ondras12345/AlarmClock-doc/sim/README.md

# Simulace
Simulace elektronických obvodů.

## LTspice
[LTspice XVII(x64) (17.0.32.0)][LTspice]

[LTspice]: https://www.analog.com/en/design-center/design-tools-and-calculators/ltspice-simulator.html

### Export do PDF
Normálně tiskne na spodním okraji cestu k souboru, ale lze to potlačit:

https://electronics.stackexchange.com/questions/365748/can-the-directory-path-on-the-schematics-be-disabled-for-the-print-in-ltspice
> If you click "Zoom to full extends" and then proceed it appears. But if you
> right after "Zoom to full extends" left click the mouse on the schematics
> anywhere and move the schematics even the smallest distance it doesn't
> appear.
