ondras12345/AlarmClock-doc/sim/models/README.md

# Third-party SPICE models
- https://www.diodes.com/part/view/BCP56/
