ondras12345/AlarmClock-doc/zkratky.tex

\nonuchapter{Seznam zkratek}
% POZOR podle abecedy to musim radit rucne...
% vim select in visual mode & :sort
\begin{acronym}[EEPROM] % nejdelsi zkratka kvuli zarovnani
    %\acro{ESD}{elektrostatický výboj}
    \acro{BLU}{podsvitová jednotka LCD\acroextra{ (\foreignlanguage{english}{backlight unit})}}
    \acro{CI}{průběžná integrace\acroextra{ (\foreignlanguage{english}{continuous integration})}}
    \acro{CLI}{příkazový řádek\acroextra{ (\foreignlanguage{english}{command line interface})}}
    \acro{CNC}{počítačové číslicové řízení\acroextra{ (\foreignlanguage{english}{computer numeric control})}}
    \acro{DPS}{deska plošných spojů}
    \acro{DRC}{\foreignlanguage{english}{Design Rules Checker}\acroextra{ (nástroj pro kontrolu návrhu DPS)}}
    \acro{EEPROM}{elektricky vymazatelná paměť pouze pro čtení\acroextra{ (\foreignlanguage{english}{electrically erasable programmable read-only memory})}}
    \acro{ERC}{\foreignlanguage{english}{Electrical Rules Checker}\acroextra{ (nástroj pro kontrolu elektrických pravidel)}}
    \acro{IDE}{vývojové prostředí\acroextra{ (\foreignlanguage{english}{integrated development environment})}}
    \acro{ISP}{\foreignlanguage{english}{in-system programming}}
    \acro{ISR}{obsluha přerušení\acroextra{ (\foreignlanguage{english}{interrupt service routine})}}
    \acro{LED}{elektroluminiscenční dioda\acroextra{ (\foreignlanguage{english}{light-emitting diode})}}
    \acro{LSB}{nejméně významný bit\acroextra{ (\foreignlanguage{english}{least significant bit})}}
    \acro{LUT}{vyhledávací tabulka\acroextra{ (\foreignlanguage{english}{lookup table})}}
    \acro{LWT}{\foreignlanguage{english}{Last Will and Testament}\acroextra{ (funkce protokolu MQTT)}}
    \acro{MCU}{mikrokontrolér\acroextra{ (jednočipový počítač; \foreignlanguage{english}{microcontroller unit})}}
    \acro{MSB}{nejvýznamnější bit\acroextra{ (\foreignlanguage{english}{most significant bit})}}
    \acro{PWM}{pulzně šířková modulace\acroextra{ (\foreignlanguage{english}{pulse-width modulation})}}
    \acro{RTC}{hodiny reálného času\acroextra{ (\foreignlanguage{english}{real-time clock})}}
    \acro{SDK}{software development kit}
    \acro{SMD}{součástka pro povrchovou montáž\acroextra{ (\foreignlanguage{english}{surface mount device})}}
    \acro{SRAM}{statická polovodičová pamět s~přímým přístupem\acroextra{ (\foreignlanguage{english}{static random-access memory})}}
    \acro{TTL}{\foreignlanguage{english}{transistor-transistor logic}}
    \acro{UART}{\foreignlanguage{english}{universal asynchronous receiver-transmitter}\acroextra{ (univerzální asynchronní přijímač-vysílač)}}
    \acro{WDT}{\foreignlanguage{english}{watchdog timer}}
    % TODO \acro{MQTT}{} ??
\end{acronym}
