ondras12345/AlarmClock-doc/dmp.tex

\documentclass[12pt,a4paper]{report}
\usepackage[utf8]{inputenc}
\usepackage[czech]{babel}
\usepackage[T1]{fontenc}

% radkovani 1,5, ale ne u footnotes, literatury, ...
% baselinestretch 1.3 je radkovani 1,5
% https://theses.cz/id/say3ul/BP.pdf
% http://mirrors.nic.cz/tex-archive/info/czech/latex-pro-pragmatiky/latex-pro-pragmatiky.pdf
%\renewcommand{\baselinestretch}{1.3}
% To by bylo i v caption apod.
% https://texfaq.org/FAQ-linespace
\usepackage[onehalfspacing]{setspace}

\usepackage[
    a4paper,
    left=40mm,
    right=15mm,
    top=25mm,
    bottom=30mm,
    % includefoot ??
    marginparwidth=35mm,
    marginparsep=3mm,
    %showframe,
]{geometry}
\usepackage{array}
%\usepackage{multirow}
\usepackage{siunitx}
\usepackage{graphicx}
\usepackage{booktabs}
%\usepackage{calc} % e.g. for calculations in desky-predni
%\usepackage{refcount} % calculations with references (Lastpage in desky-predni)
%\usepackage{makecell} % for multiline cells
%\usepackage{lastpage}
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
\usepackage{acronym}
\usepackage[titles]{tocloft}
\usepackage[
    disable
    % todonotes can do weird stuff with circuitikz/tikz node[above], even when
    % disabled
]{todonotes}
\reversemarginpar
\usepackage{dirtree}
\usepackage{pdfpages}

% Typesetting LCD displays with custom characters.
% Full documentation for this package can be build from sources downloaded from
% CTAN.
\usepackage{lcd}
\usepackage{longtable}
\usepackage{csvsimple}
\usepackage{chngcntr}

\usetikzlibrary{fit}

%\usepackage{arydshln} % dashed lines in tabular; should be one of the last packages (http://texdoc.net/texmf-dist/doc/latex/arydshln/arydshln-man.pdf)

\graphicspath{{figures/}{sim/}{hodnoty/}} % figures and gnuplot EPS stuff

% TODO patching babel failed
\makeatletter
\newcommand\my@hyphen{-}
\patchcmd\select@language{-}{\my@hyphen }{}{\fail}
\makeatother

% http://www.gnuplotting.org/labels-with-white-background-in-latex-terminals/
\newcommand{\hl}[1]{\setlength{\fboxsep}{0.75pt}\colorbox{white}{#1}}

% robust command because of \listoffigures
\DeclareRobustCommand{\HAentity}[1]{\texttt{\detokenize{#1}}}  % detokenize makes underscores printable
\DeclareRobustCommand{\HAdomain}[1]{\href{https://www.home-assistant.io/integrations/#1/}{\texttt{\detokenize{#1}}}}
\DeclareRobustCommand{\HAintegration}[1]{\href{https://www.home-assistant.io/integrations/#1/}{\texttt{\detokenize{#1}}}}
\DeclareRobustCommand{\shellcmd}[1]{\texttt{\detokenize{#1}}}  % POZOR na '--' ve flags (\verb|--tohle-je-lepsi|)
\newcommand{\HAstate}{\texttt}
\DeclareRobustCommand{\topic}[1]{\texttt{\detokenize{#1}}}
\newcommand{\gitrepo}{\texttt}
\newcommand{\gitbranch}[1]{\texttt{#1}}
%\DeclareRobustCommand{\repopath}[1]{\texttt{\detokenize{#1}}}
% \detokenize would disallow use of \fshyp
\DeclareRobustCommand{\repopath}{\begingroup\catcode`_=12\dorepopath}
\DeclareRobustCommand{\dorepopath}[1]{\texttt{#1}\endgroup}
\newcommand{\filename}{\texttt}
\DeclareRobustCommand{\yamlkey}[1]{\texttt{\detokenize{#1}}}
\DeclareRobustCommand{\inikey}[1]{\texttt{\detokenize{#1}}}
\newcommand{\port}[1]{\texttt{#1}} % TCP/UDP port
\newcommand{\MCUpin}{\texttt}
\newcommand{\IIC}{I\textsuperscript{2}C}
\newcommand{\ipaddress}{\texttt}

\title{Chytrý budík}
\author{Ondřej Sluka}
\date{29. dubna 2022}  % je i na titlepage

\frenchspacing
\sisetup{
    output-decimal-marker = {,},
    list-separator = {; },
    list-final-separator = { a~},
    list-pair-separator = { a~},
    group-digits,
    group-minimum-digits=4,
    range-phrase=\text{--},
    range-units=single,
    exponent-product=\ensuremath{\cdot}
}

\DeclareSIUnit{\sample}{Sa}
\DeclareSIUnit{\baud}{Bd}

\input{lstsetup}

% fancyhdr does not seem to work well with documentclass report
% headers and footers
%\setlength{\headheight}{15pt} % prevents a warning most likely caused by diacritics
%\pagestyle{fancy}
%%\renewcommand{\headrulewidth}{0pt}
%\fancyhf{} % clears header and footer, otherwise "plain" will appear
%%\fancyhead{} % only clears the header
%\lhead{\theauthor}
%\rhead{\thepage}
%\fancyhfoffset{0pt} % fixes width after \newgeometry

% Roztrhana matika
\allowdisplaybreaks

% kapitoly bez slove "Kapitola"
\titleformat{\chapter}[hang]
    {\Huge\bfseries}{\thechapter}{20pt}{\Huge\bfseries}

% kapitola bez cisla
\newcommand{\nonuchapter}[1]
{%
    \chapter*{#1}%
    \addcontentsline{toc}{chapter}{#1}% v toc, ale bez cisla
    \phantomsection%
}

% seznam priloh
% https://tex.stackexchange.com/questions/26732/how-to-get-a-list-of-appendices
\newcommand{\listappendicesname}{Seznam příloh}
\newlistof{appendices}{apc}{\listappendicesname}
\renewcommand{\theappendices}{\Alph{appendices}}
\newcommand{\newappendix}[1]{%
    \refstepcounter{appendices}
    \section*{Příloha \theappendices: #1}
    \phantomsection
    \addcontentsline{apc}{appendices}{\protect\numberline{\theappendices}#1}
}

\input{LCDchars}

\AtBeginDocument{\addtocontents{toc}{\protect\thispagestyle{empty}}} % remove page number on first page of the TOC

\begin{document}

\input{titlepage}

\includepdf{zadani.pdf}

\pagestyle{empty}

\clearpage
\input{anotace}
\vfill
\input{prohlaseni}

\clearpage
\mbox{}
\vfill
\input{podekovani}

\addtocontents{toc}{\protect\label{toc}}%
\tableofcontents

\clearpage
\pagestyle{plain}

\input{uvod}

\chapter{Hardware a~firmware}
\input{MCU}
\input{platformio}
\input{GUI}
\input{zvuk}
\input{ambient}
\input{UPS}
\input{UART}
\input{PCB}

\chapter{Software}
\input{PyAlarmClock}
\input{AlarmClockWeb}
\input{HomeAssistant}

\input{zaver}

% Reference a odkazy
{\singlespacing%
\printbibliography[title={Odkazy a~literatura}]
\phantomsection
\addcontentsline{toc}{chapter}{Odkazy a~literatura}  % v toc, ale bez cisla
}

{\singlespacing%
\listoffigures
\phantomsection
\addcontentsline{toc}{chapter}{\listfigurename}  % v toc, ale bez cisla
}

{\singlespacing%
\listoftables
\phantomsection
\addcontentsline{toc}{chapter}{\listtablename}  % v toc, ale bez cisla
}

{\singlespacing%
\input{zkratky}
}

\listoftodos

\listofappendices
\addcontentsline{toc}{chapter}{\listappendicesname}

\include{prilohy}

\end{document}
