ondras12345/AlarmClock-doc/LCDchars.tex

% This file was automatically generated by ./script/LCDchars from prilohy/AlarmClock/lib/GUI/LCDchars.cpp.

\DefineLCDchar{home}{%
    00100%
    01110%
    11111%
    10001%
    10001%
    10001%
    11111%
    00000%
}

\DefineLCDchar{bell}{%
    00100%
    01110%
    01110%
    01110%
    01110%
    11111%
    00000%
    00100%
}

\DefineLCDchar{timer}{%
    11111%
    01110%
    00100%
    00100%
    01110%
    11111%
    00000%
    00000%
}

\DefineLCDchar{apply}{%
    00000%
    00000%
    00001%
    00010%
    10100%
    01000%
    00000%
    00000%
}

\DefineLCDchar{cancel}{%
    00000%
    10001%
    01010%
    00100%
    01010%
    10001%
    00000%
    00000%
}
