ondras12345/AlarmClock-doc/titlepage.tex

\begin{titlepage}
    \begin{center}
        \begin{minipage}[c]{0.18\textwidth}
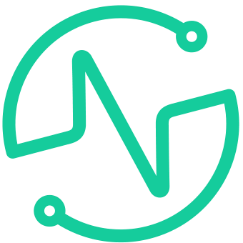
[picture p35: figures/spse-logo.png]
            
        \end{minipage}
        \hfill
        \begin{minipage}[c]{0.8\textwidth}
            \centering
            \bfseries
            \large
            \noindent
            Vyšší odborná škola \\
            a~Střední průmyslová škola elektrotechnická \\
            Plzeň, Koterovská 85
        \end{minipage}

        \vfill

        {\LARGE\bfseries\textsc{Dlouhodobá maturitní práce s~obhajobou}}
    \end{center}
    \vfill
    \noindent
    {\Large Téma: \textbf{\thetitle}}
    \vfill
    {%
        \bfseries
        \noindent
        \begin{tabular}{@{}ll@{}}
            Autor práce:    & \theauthor \\
            Třída:          & 4.O \\
            Vedoucí práce:  & Ing. Karel Hajžman\\
            Dne:            & \thedate
        \end{tabular}

        \vspace*{1cm}
        \noindent
        Hodnocení:
    }
\end{titlepage}
