ondras12345/AlarmClock-doc/sim/cropme_vypadek-RC.pdf

R1
100k

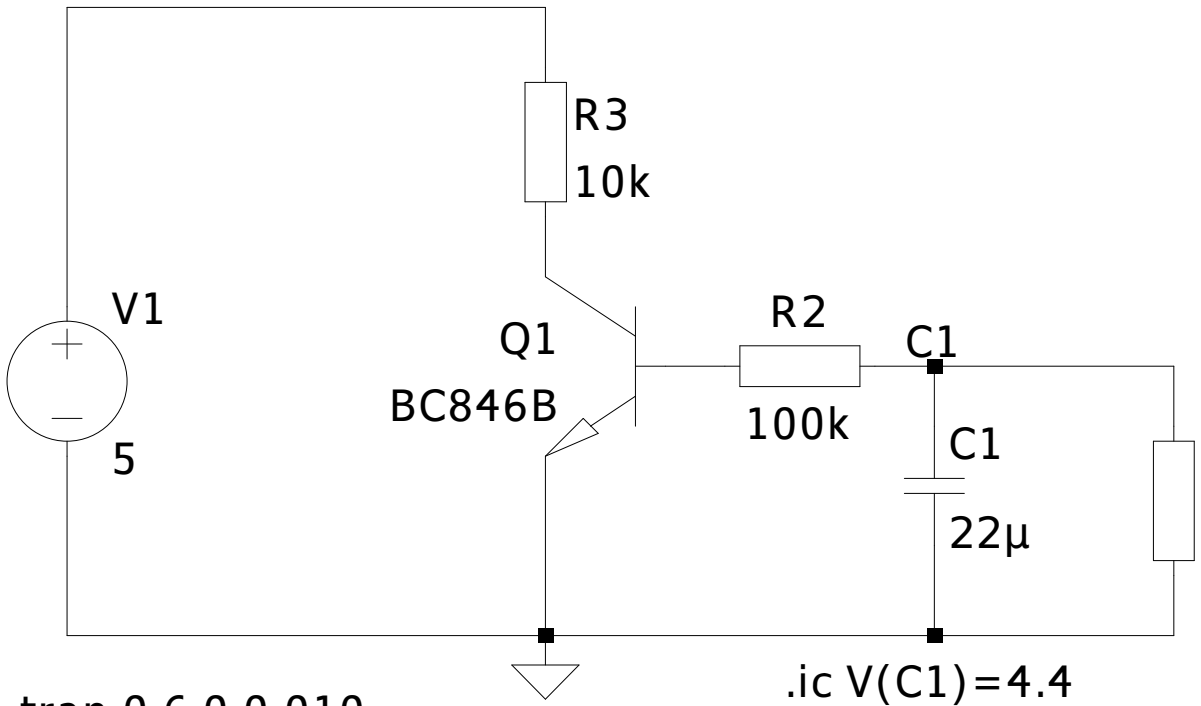
[picture p36: figure]

.tran 0 6 0 0.010 | .ic V(C1)=4.4
