ondras12345/AlarmClock-doc/prilohy/TDA2030-dokumentace.pdf

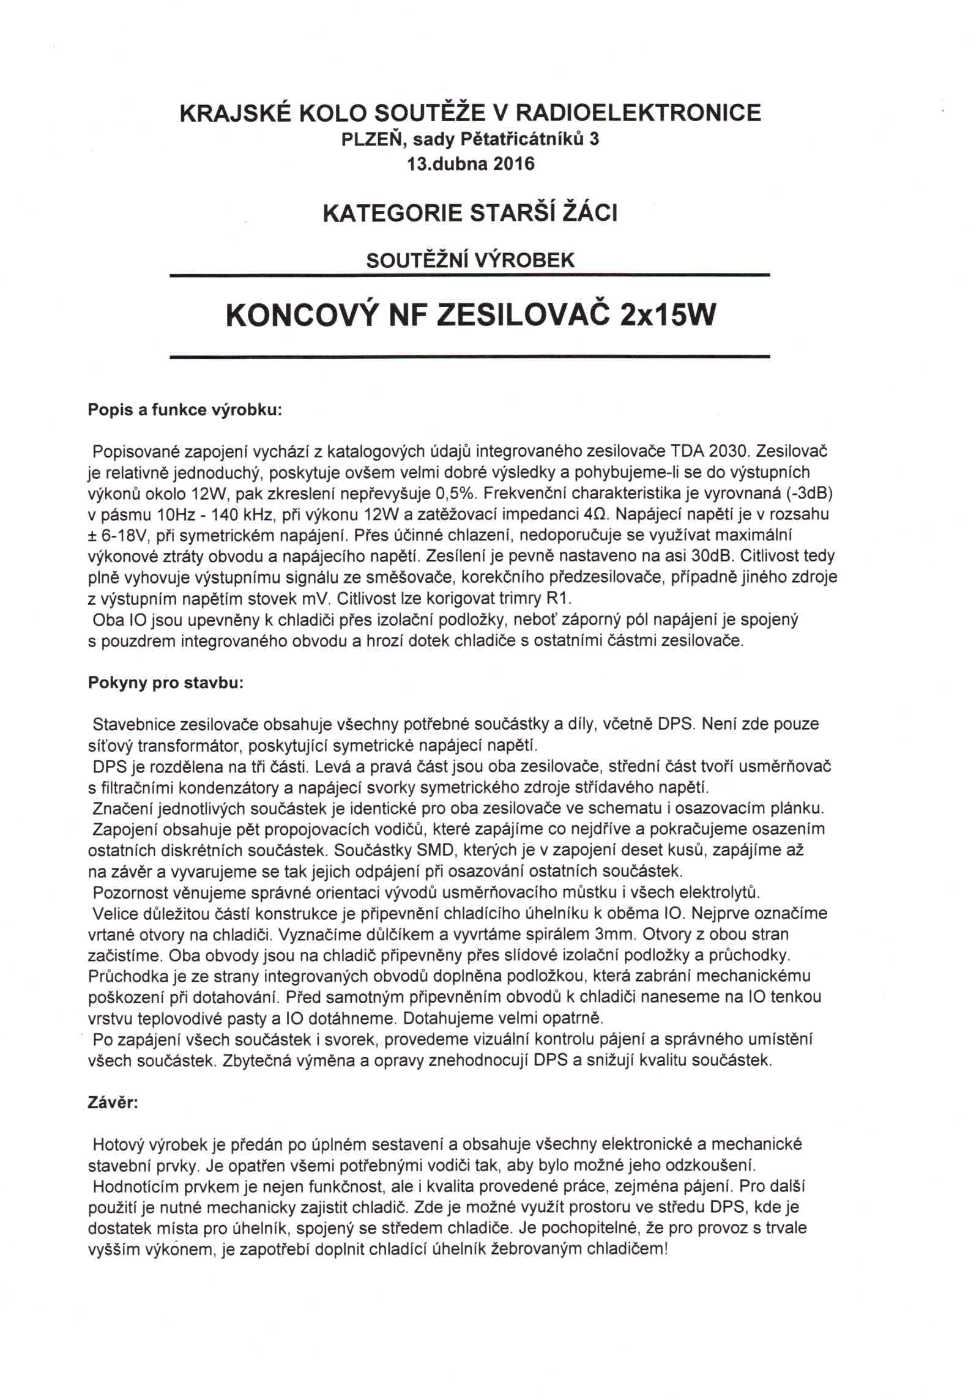
[picture p37: page 1]
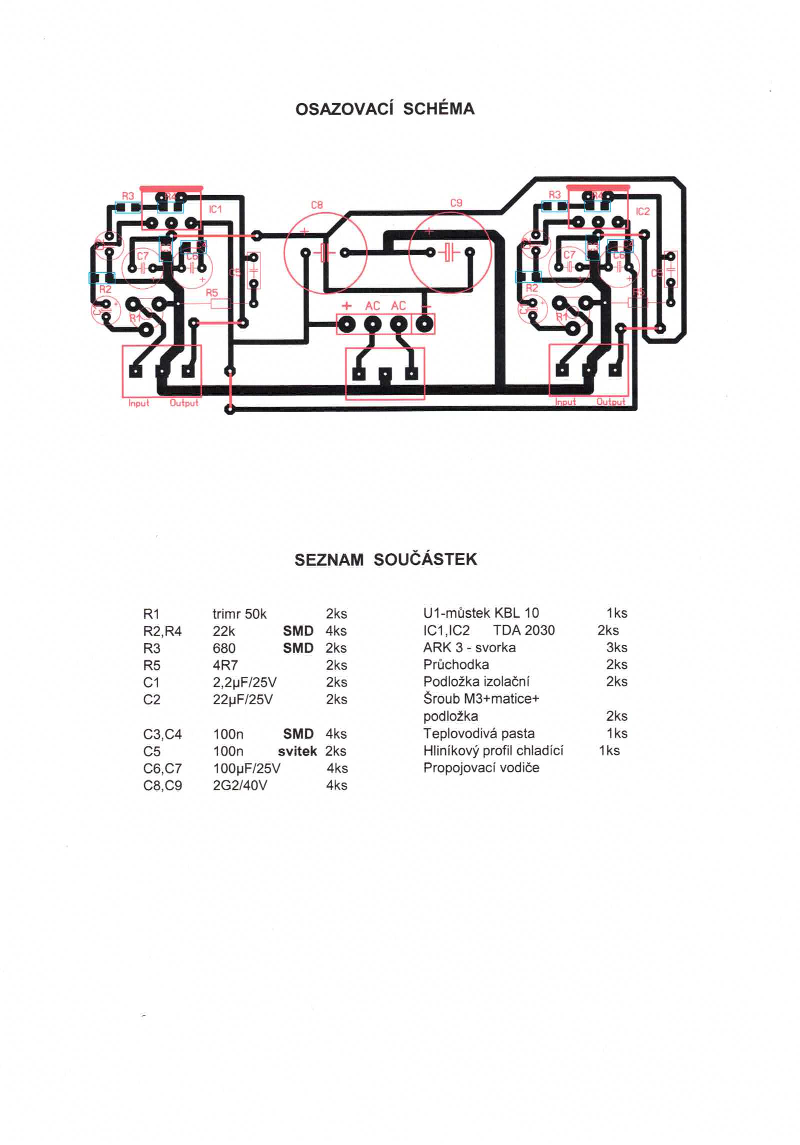
[picture p38: page 2]
