ondras12345/AlarmClock-doc/sim/cropme_zvuk-D-filtr.pdf

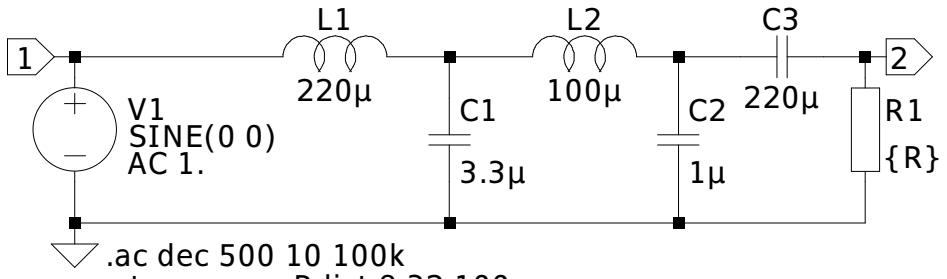
[picture p39: figure]
SINE(0 0); .ac dec 500 10 100k

.step param R list 8 32 100
