ondras12345/AlarmClock-doc/figures/prezentace/krabicka-CNC-laser.jpg

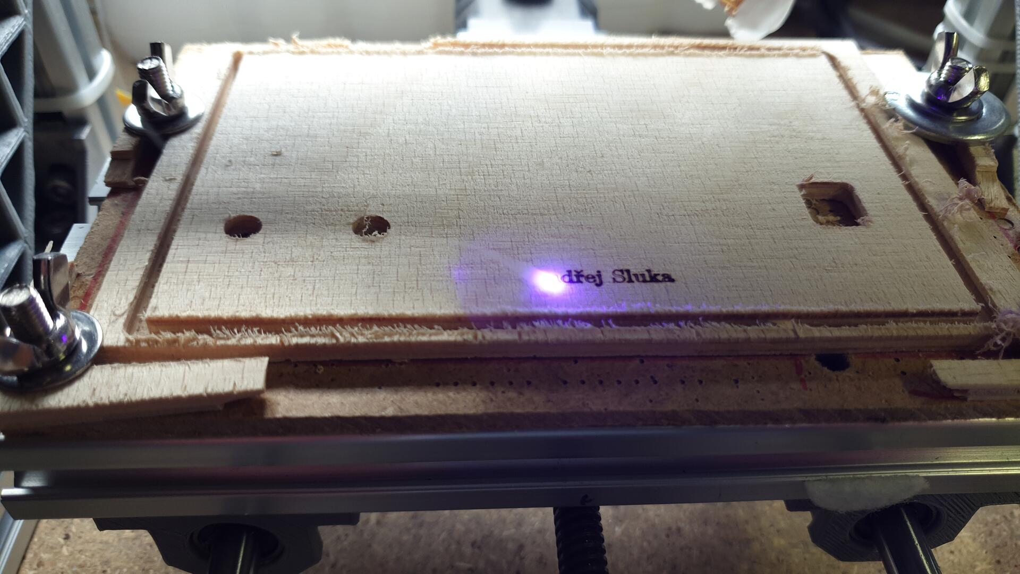
figures/prezentace/krabicka-CNC-laser.jpg
