ondras12345/AlarmClock-doc/figures/prezentace/krabicka-CNC-poskozeni.jpg

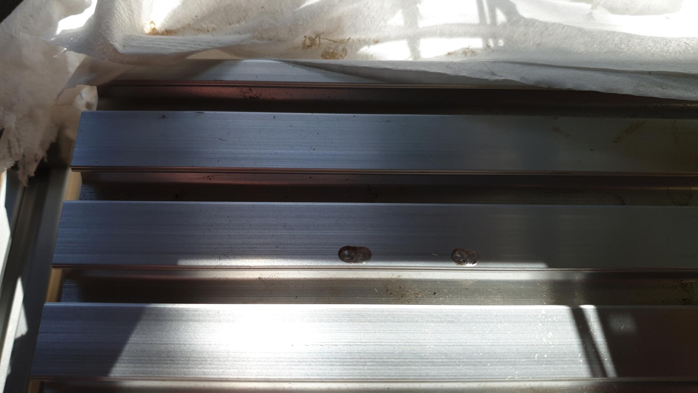
figures/prezentace/krabicka-CNC-poskozeni.jpg
