ondras12345/AlarmClock-doc/figures/prezentace/krabicka-CNC-repro.jpg

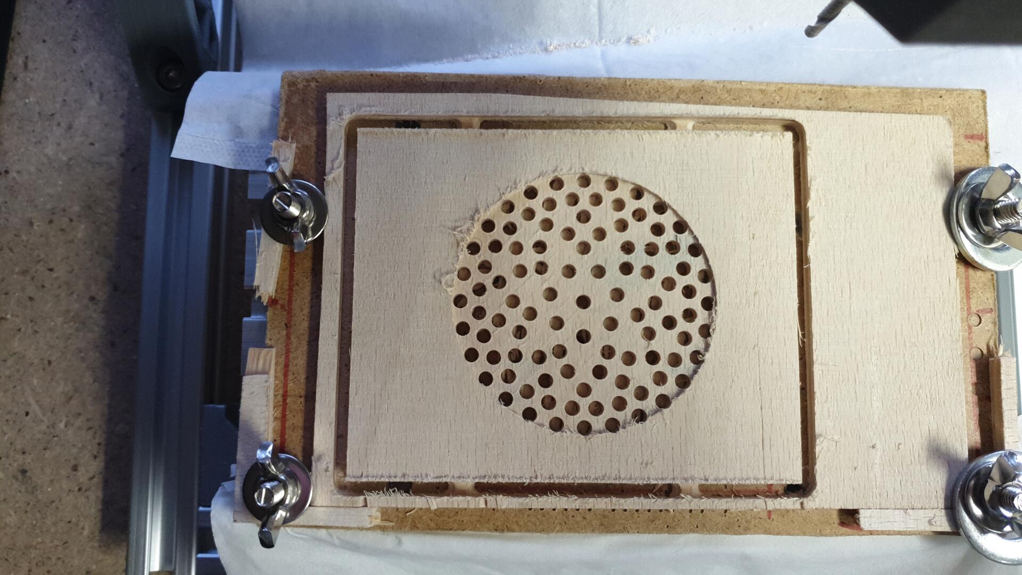
figures/prezentace/krabicka-CNC-repro.jpg
