ondras12345/AlarmClock-doc/figures/prezentace/PCB-bot.jpg

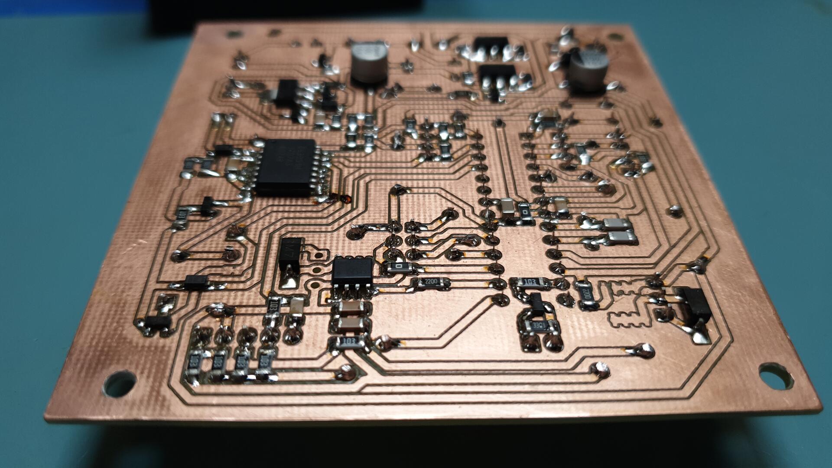
figures/prezentace/PCB-bot.jpg
