ondras12345/AlarmClock-doc/figures/prezentace/PCB-top.jpg

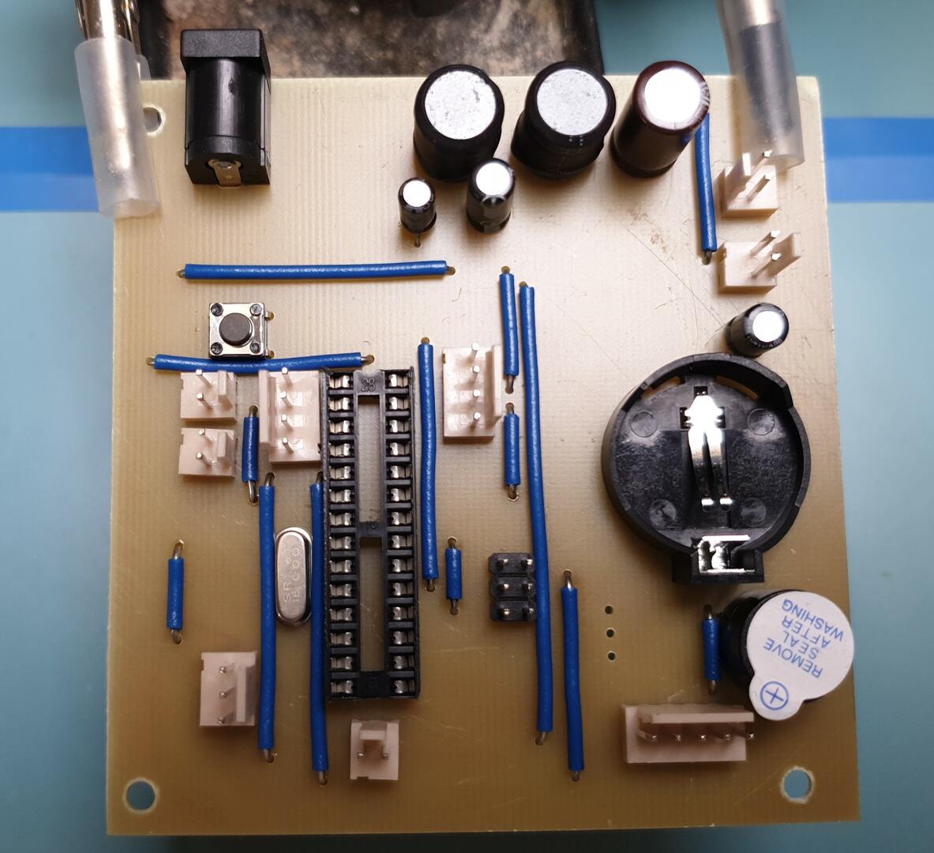
figures/prezentace/PCB-top.jpg
