ondras12345/AlarmClock-doc/figures/prezentace/zvuk-stul1.jpg

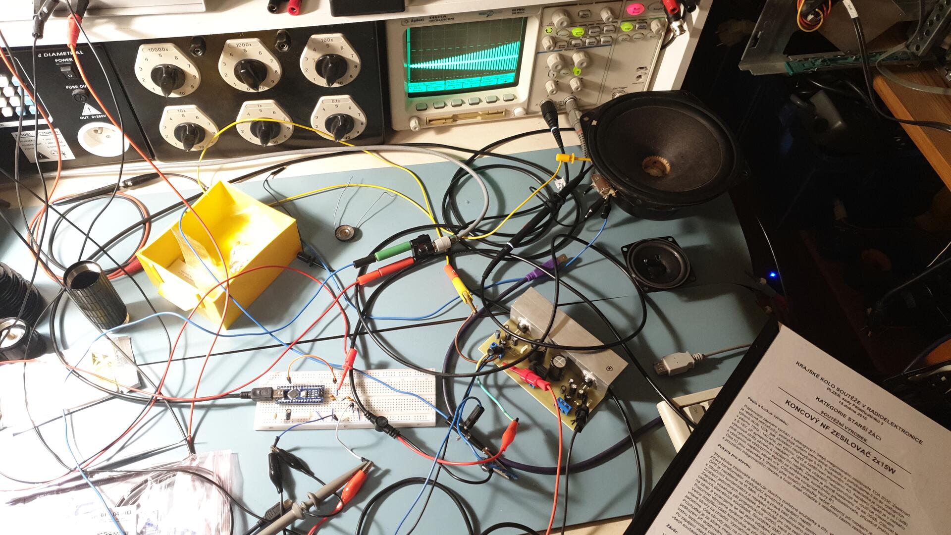
figures/prezentace/zvuk-stul1.jpg
