ondras12345/AlarmClock-doc/figures/prezentace/zvuk-stul2.jpg

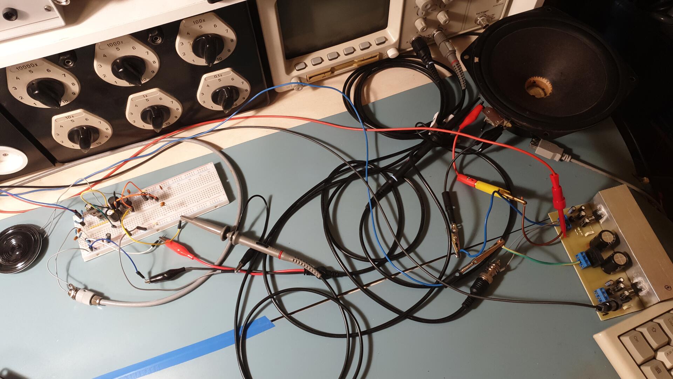
figures/prezentace/zvuk-stul2.jpg
