ondras12345/AlarmClock-doc/lstsetup.tex

\makeatletter
\@ifpackageloaded{setspace}{%
    % https://tex.stackexchange.com/questions/55802/latex-lstinline
    \newcommand{\mysinglespacing}{%
      \setstretch{1}% no correction afterwards
    }
}{%
    \newcommand{\mysinglespacing}{}
}
\makeatother

\newcommand{\lstpostbreak}{\mbox{$\hookrightarrow$\space}}

% https://tex.stackexchange.com/questions/30512/how-to-insert-code-with-accents-with-listings
\lstset{
  basicstyle=\mysinglespacing\fontfamily{lmtt}\selectfont,
  columns=flexible,
  breaklines=true,
  postbreak=\lstpostbreak,
  showstringspaces=false,
  literate=%
    {á}{{\'a}}1
    {í}{{\'i}}1
    {é}{{\'e}}1
    {ý}{{\'y}}1
    {ú}{{\'u}}1
    {ó}{{\'o}}1
    {ě}{{\v{e}}}1
    {š}{{\v{s}}}1
    {č}{{\v{c}}}1
    {ř}{{\v{r}}}1
    {ž}{{\v{z}}}1
    {ď}{{\v{d}}}1
    {ť}{{\v{t}}}1
    {ň}{{\v{n}}}1
    {ů}{{\r{u}}}1
    {Á}{{\'A}}1
    {Í}{{\'I}}1
    {É}{{\'E}}1
    {Ý}{{\'Y}}1
    {Ú}{{\'U}}1
    {Ó}{{\'O}}1
    {Ě}{{\v{E}}}1
    {Š}{{\v{S}}}1
    {Č}{{\v{C}}}1
    {Ř}{{\v{R}}}1
    {Ž}{{\v{Z}}}1
    {Ď}{{\v{D}}}1
    {Ť}{{\v{T}}}1
    {Ň}{{\v{N}}}1
    {Ů}{{\r{U}}}1
}
  %literate={█}{{\#}}1

\lstdefinestyle{numbers}{
    numbers=left,
    xleftmargin=2em,
    %framexleftmargin=1.5em,  % cisla radku uvnitr ramecku, vypada hnusne
}

\lstdefinestyle{terminal}{
    basicstyle=\ttfamily\mysinglespacing,
    basewidth={0.5em,0.5em},
    frame=single,
    frameround=tttt,
}

\lstdefinelanguage{Ini}
{
    morecomment=[s][\bfseries]{[}{]},
    morecomment=[l]{\#},
    morecomment=[l]{;},
    morekeywords={},
    literate =%
        {-}{{-}}1
}

\lstdefinelanguage{yaml}
{
    columns=[l]flexible,
    %
    morekeywords={%
        true,false,null,
        !secret,!include,!include_dir_list,!include_dir_named,
        !include_dir_merge_list,!include_dir_merge_named
    },
    alsoletter={!},
    sensitive=false,
    %
    comment=[l]{\#},
    %
    morestring=[d]',
    morestring=[b]",
    %stringstyle=\mdseries\ttfamily\itshape,  % only for testing
    showstringspaces = false,
    % multiline strings >- -- looks too hard to implement
    %
    %moredelim=[l][\color{orange}]{\&},
    %moredelim=[l][\color{magenta}]{*},
    %
    % TODO YAML syntax highlighting - \bfseries keys not compatible with multiline strings
    %basicstyle=\bfseries\mysinglespacing,
    %moredelim=**[il][\mdseries{:}]{:}, % switch to value style at :
    %moredelim=[l][\mdseries]{:}, % switch to value style at :
    %
    % alsolanguage jinja2 -- too complicated
    %
    literate =  {---}{{\llap{\mdseries-{-}-}}}3
                {>}{{\textgreater}}1
                {>-}{{\textgreater-}}2
                {|}{{\textbar}}1
                {|-}{{\textbar-}}2
                % make dashes shorter
                {-}{{-}}1
                {-\ }{{\mdseries-\ }}2,
}

\lstdefinelanguage{Poke}
{
    sensitive=true,
    % see poke.vim in poke 2.1
    morekeywords={%
        % statement
        assert,break,continue,return,
        type,unit,fun,method,
        var,
        % operators
        in,sizeof,as,isa,unmap,
        % conditionals
        if,else,where,
        %
        struct,union,pinned,
        % loops
        while,for,
        % imports
        load,
        try,catch,until,raise,
        % exceptions - skipped
        % types
        string,void,int,uint,bit,nibble,
        byte,char,ushort,short,ulong,long,
        uint8,uint16,uint32,uint64,
        off64,uoff64,offset,
        Comparator,POSIX_Time32,POSIX_Time64,
        big,little,any,
        % constants
        ENDIAN_LITTLE,ENDIAN_BIG,
        IOS_F_READ,IOS_F_WRITE,IOS_F_CREATE,
        IOS_M_RDONLY,IOS_M_WRONLY,IOS_M_RDWR,
        load_path,NULL,OFFSET,
        % Poke std lib
        print,printf,catos,stoca,atoi,ltos,reverse,
        ltrim,rtrim,strchr,qsort,crc32,alignto,
        open,close,flush,get_ios,set_ios,iosize,
        rand,get_endian,set_endian,strace,exit,
        getenv,
        % integer literals - skipped
        % Units
        b,M,B,
        Kb,KB,Mb,MB,Gb,GB,
        Kib,KiB,Mib,MiB,Gib,GiB,
        % offsets - skipped
    },
    morecomment=[s]{/*}{*/},
    morecomment=[l]//,
    morestring=[b]",
    moredelim=[s][keywordstyle]{<}{>}  % uint<x>
}

% https://tex.stackexchange.com/questions/312/correctly-typesetting-a-tilde/160898#160898
\makeatletter
\newcommand\midtilde@raisedtilde[1][.5]{\raisebox{#1ex}{\texttildelow}}
\def\midtilde@normaltilde{\texttildelow}

\newcommand\midtilde%
{%
  \expandafter\in@\expandafter{\f@family}%
    {cmr,cmss,cmtt,cmm,cmsy,cmx,%
    lmr,lmss,lmtt,lmm,lmsy,lmx,%
    pxr,pxss,pxm,pxsy,pxx,%
    txr,txss,txm,txsy,txx}%
  \ifin@%
    \midtilde@raisedtilde%
  \else%
    \expandafter\in@\expandafter{\f@family}%
    {pxtt,txtt}%
    \ifin@%
      \midtilde@raisedtilde[.35]%
    \else%
      \midtilde@normaltilde%
    \fi%
  \fi%
}
\makeatother
\lstdefinelanguage{mybash}
{
    language = bash,
    literate =%
        % $# is not a comment...
        {\$\#}{{{\$\#}}}2 {\$\# }{{{\$\# }}}2
        % make dashes shorter
        {-}{{-}}1
        {~}{{\midtilde}}1
        % komentare s diakritikou
        {á}{{\'a}}1
        {í}{{\'i}}1
        {é}{{\'e}}1
        {ý}{{\'y}}1
        {ú}{{\'u}}1
        {ó}{{\'o}}1
        {ě}{{\v{e}}}1
        {š}{{\v{s}}}1
        {č}{{\v{c}}}1
        {ř}{{\v{r}}}1
        {ž}{{\v{z}}}1
        {ď}{{\v{d}}}1
        {ť}{{\v{t}}}1
        {ň}{{\v{n}}}1
        {ů}{{\r{u}}}1
        {Á}{{\'A}}1
        {Í}{{\'I}}1
        {É}{{\'E}}1
        {Ý}{{\'Y}}1
        {Ú}{{\'U}}1
        {Ó}{{\'O}}1
        {Ě}{{\v{E}}}1
        {Š}{{\v{S}}}1
        {Č}{{\v{C}}}1
        {Ř}{{\v{R}}}1
        {Ž}{{\v{Z}}}1
        {Ď}{{\v{D}}}1
        {Ť}{{\v{T}}}1
        {Ň}{{\v{N}}}1
        {Ů}{{\r{U}}}1
}

\lstdefinelanguage{Dockerfile}{
    keywords={FROM, RUN, COPY, ADD, ENTRYPOINT, CMD,  ENV, ARG, WORKDIR, EXPOSE, LABEL, USER, VOLUME, STOPSIGNAL, ONBUILD, MAINTAINER},
    sensitive=false,
    comment=[l]{\#},
    morestring=[b]',
    morestring=[b]",
    literate =%
        {-}{{-}}1
}

\lstdefinelanguage{myC++}{
    language=C++,
    morekeywords={%
        uint8_t, uint16_t, uint32_t,
        int8_t, int16_t, int32_t,
        size_t,
        constexpr,
        byte
    }
}

\lstdefinelanguage{hashcomment}{
    comment=[l]{\#},
}
