ondras12345/AlarmClock-doc/sim/cropme_ambient-linear-testing.pdf

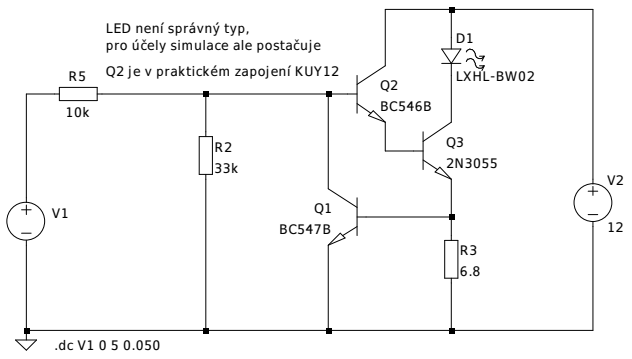
[picture p47: figure]
LXHL-BW02; LED není správný typ, pro účely simulace ale postačuje; Q2 je v praktickém zapojení KUY12
