ondras12345/AlarmClock-doc/sim/ambient-linear-testing.txt

v1	I(D1)
0.000000000000000e+000	6.837406e-007
5.000000000000000e-002	6.837437e-007
1.000000000000000e-001	6.837477e-007
1.500000000000000e-001	6.837556e-007
2.000000000000000e-001	6.837801e-007
2.500000000000000e-001	6.838753e-007
3.000000000000000e-001	6.842760e-007
3.500000000000000e-001	6.859941e-007
4.000000000000000e-001	6.933336e-007
4.500000000000000e-001	7.235419e-007
4.999999999999999e-001	8.336288e-007
5.499999999999999e-001	1.154076e-006
6.000000000000000e-001	1.916407e-006
6.500000000000000e-001	3.569404e-006
7.000000000000001e-001	7.055571e-006
7.500000000000001e-001	1.435287e-005
8.000000000000002e-001	2.957887e-005
8.500000000000002e-001	6.122919e-005
9.000000000000002e-001	1.265581e-004
9.500000000000003e-001	2.595233e-004
1.000000000000000e+000	5.229318e-004
1.050000000000000e+000	1.020096e-003
1.100000000000000e+000	1.889184e-003
1.150000000000000e+000	3.260947e-003
1.200000000000000e+000	5.199178e-003
1.250000000000000e+000	7.680921e-003
1.300000000000001e+000	1.062855e-002
1.350000000000001e+000	1.395130e-002
1.400000000000001e+000	1.756837e-002
1.450000000000001e+000	2.141537e-002
1.500000000000001e+000	2.544321e-002
1.550000000000001e+000	2.961489e-002
1.600000000000001e+000	3.390243e-002
1.650000000000001e+000	3.828435e-002
1.700000000000001e+000	4.274363e-002
1.750000000000001e+000	4.726535e-002
1.800000000000001e+000	5.183231e-002
1.850000000000001e+000	5.641262e-002
1.900000000000001e+000	6.092382e-002
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
