ondras12345/AlarmClock-doc/sim/cropme_ambient-linear-prod.pdf

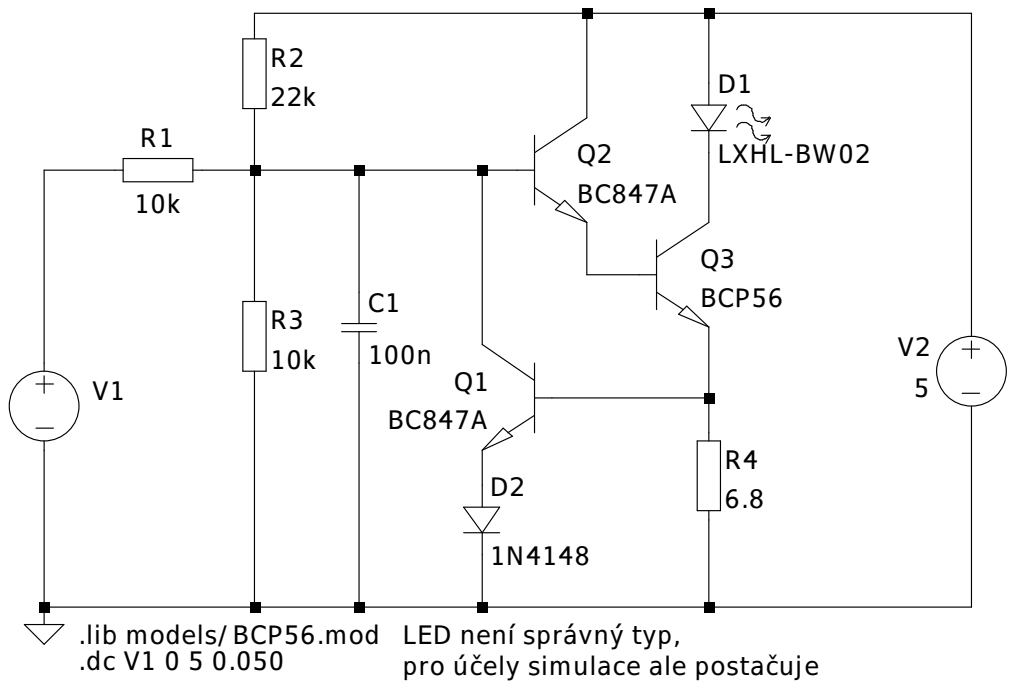
[picture p48: page 1]

.lib models/BCP56.mod LED není správný typ,

pro účely simulace ale postačuje
