ondras12345/AlarmClock-doc/figures/cropme_ambient-linear-testing.pdf

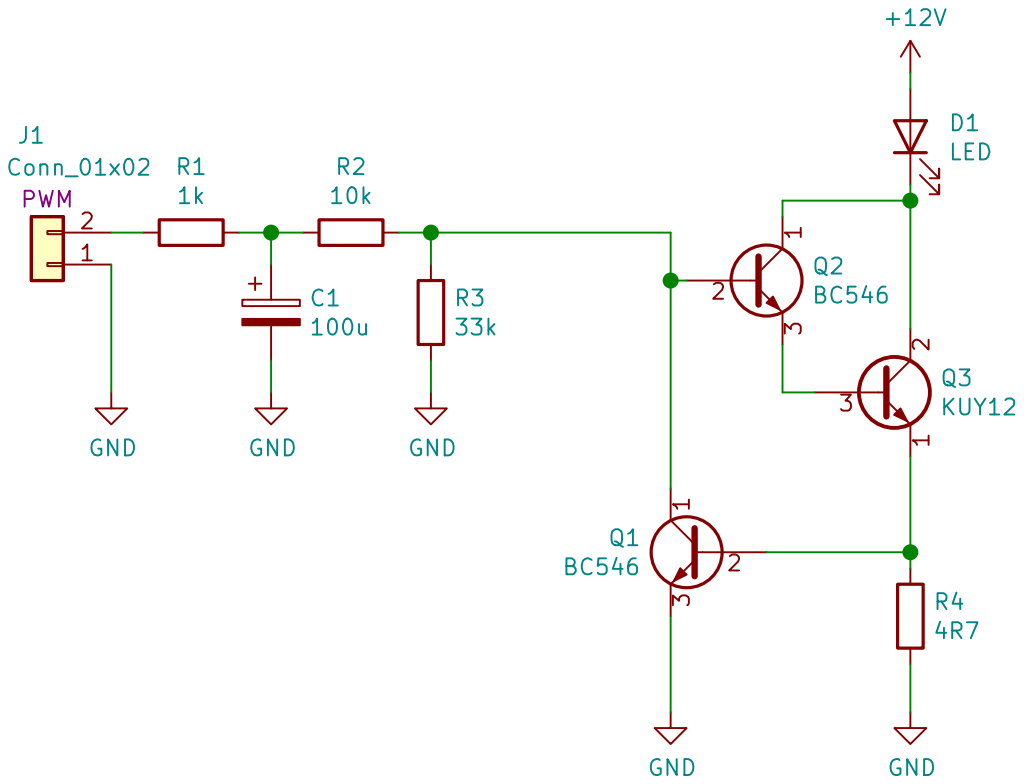
[picture p49: page 1]
