ondras12345/AlarmClock-doc/sim/vypadek-RC.asc

C1: cap; 22µ
Q1: npn; BC846B
R1: EuropeanResistor; 100k
R2: EuropeanResistor; 100k
R3: EuropeanResistor; 10k
V1: voltage; 5
Named nets: 0, C1
.tran 0 6 0 0.010
.ic V(C1)=4.4
