ondras12345/AlarmClock-doc/sim/zvuk-D-filtr.asc

C1: cap; 3.3µ
C2: cap; 1µ
C3: cap; 220µ
L1: ind; 220µ
L2: ind; 100µ
R1: EuropeanResistor; {R}
V1: voltage; SINE(0 0); AC 1.
Named nets: 0, 2, 1
.ac dec 500 10 100k
.step param R list 8 32 100
