ondras12345/AlarmClock-doc/sim/zvuk-silence.asc

C1: cap; 100n
R1: res; 1k
V1: voltage; PULSE(0 2.5 0 1p 1p 500u 1m)
Named nets: 0, 1, 2
.tran 0 2m 0
