ondras12345/AlarmClock-doc/sim/zvuk-lin-filtr.asc

C1: cap; 10n
C2: cap; {C}
R1: res; 1k
R2: res; 10k
R3: res; 1k
V1: voltage; SINE(0 1 AC 1.)
Named nets: 0, 2, 1
.ac dec 100 20 60e3
.step param C list 0n 10n
