ondras12345/AlarmClock-doc/prilohy/grbl-config.txt

Grbl 1.1h ['$' for help]
$$
$0=10
$1=25
$2=0
$3=5
$4=0
$5=0
$6=0
$10=1
$11=0.010
$12=0.002
$13=0
$20=1
$21=0
$22=1
$23=3
$24=25.000
$25=500.000
$26=250
$27=1.000
$30=1000
$31=0
$32=0
$100=800.000
$101=800.000
$102=800.000
$110=1000.000
$111=800.000
$112=500.000
$120=10.000
$121=10.000
$122=10.000
$130=154.000
$131=100.000
$132=41.700
ok
