ondras12345/AlarmClock-doc/(commit log)

2022-02-28 Tabulka Arduino piny vs MCU piny
2022-03-01 Obrazek PWM signal kodujici sinusoidu
2022-03-11 Konfigurace Grbl v priloze
    [grbl-config.txt]
2022-04-01 Info o vyrobe PCB
2022-04-09 Oprava kolize nazvu \label{app:PCB}
2022-04-10 Mereni skutecne charakteristiky stmivace
    [e_ambient.csv, m_ambient.ods]
2022-04-13 Vyreseni nekterych \todo poznamek
    [BOM.csv]
2022-04-14 UART; spravny dsh ATmega328p
2022-04-21 Vice info o UART
2022-04-24 Upravy po precteni
    [BOM.csv]
2022-04-25 vlna -r -l -v KkSsZzVvOoIiAaUu *.tex
    + rucni opravy.
    This is program vlna, version 1.5, (c) 1995, 2002, 2009, 2010 Petr Olsak
    ~~~ file: AlarmClockWeb.tex lines: 182, changes: 46
    ~~~ file: ambient.tex lines: 261, changes: 64
    ~~~ file: anotace.tex lines: 6, changes: 5
    ~~~ file: dmp.tex lines: 263, changes: 1
    ~~~ file: GUI.tex lines: 314, changes: 61
    ~!~ warning: text/math/verb mode mismatch, file: HomeAssistant.tex, line: 37
    ~~~ file: HomeAssistant.tex lines: 250, changes: 61
    ~~~ file: LCDchars.tex lines: 58, changes: 0
    ~~~ file: lstsetup.tex lines: 256, changes: 0
    ~~~ file: MCU.tex lines: 74, changes: 27
    ~~~ file: PCB.tex lines: 335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
2022-05-19 Prezentace k obhajobe
    Jpeg obrazky jsou zkomprimovane.
    [BOM-ceny.csv]
